AdrienRenggli/Watermeter-Integra/CAD/Watermeter.step

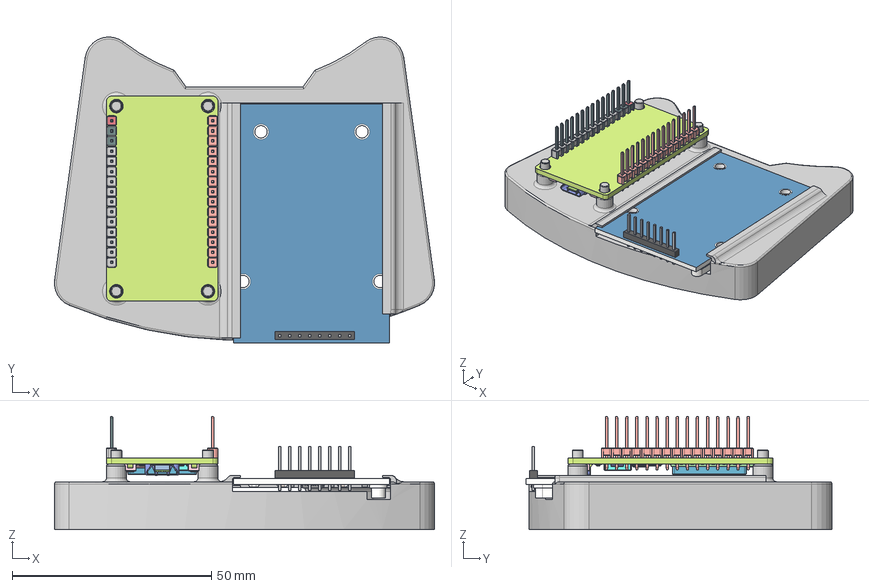
[picture p2: CAD file, 2026-10-19]
CAD/Watermeter.step
95.4 x 76.9 x 28.4 mm
